piotrb5e3/AT89C2051_programmer/schematic/schematic.pdf

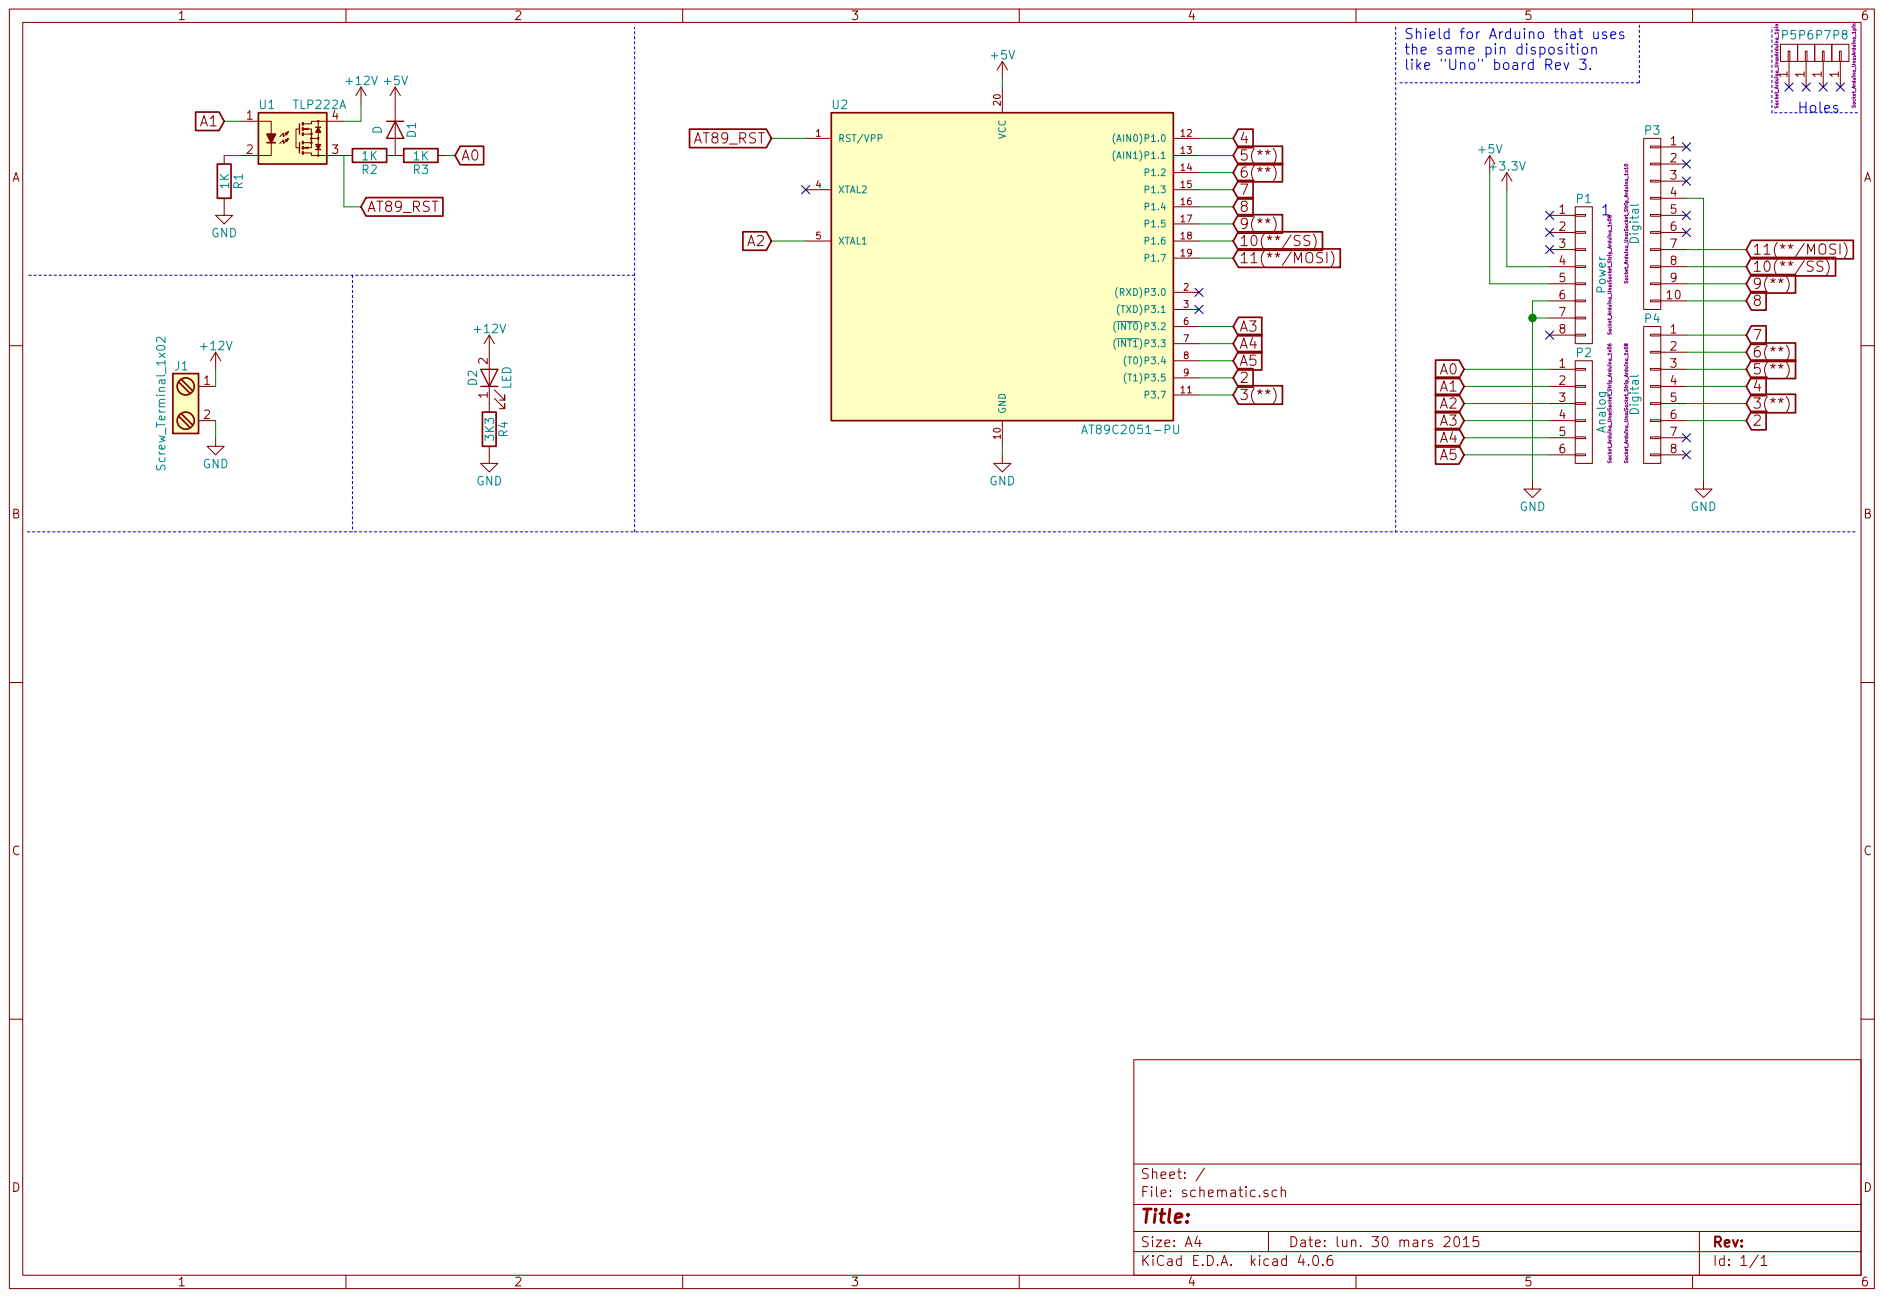
[picture p1: page 1]

Holes Shield for Arduino that uses
the same pin disposition
like "Uno" board Rev 3. 1
10 P3 Digital Socket_Arduino_Uno:Socket_Strip_Arduino_1x10 1

Id: 1/1 Title: File: schematic.sch Sheet: /
