piotrb5e3/AT89C2051_programmer/schematic/schematic.sch

## KiCad design schematic/schematic.sch (2017-05-21)

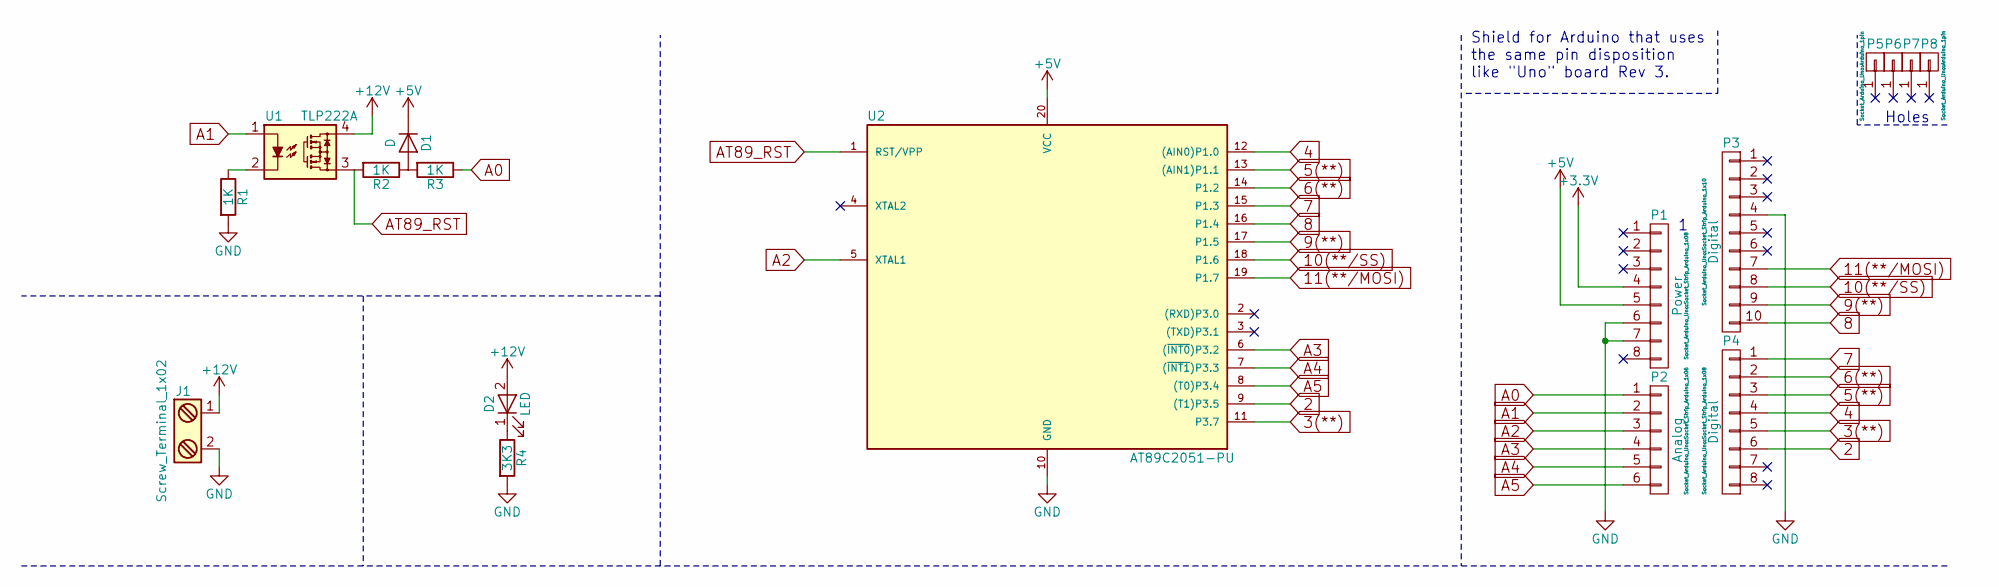
[picture p2: schematic schematic.sch]

Parts:
D1: D; D_MELF
D2: LED; LED_0805
J1: Screw_Terminal_1x02; TerminalBlock_Pheonix_MPT-2.54mm_2pol
P1: Power; Socket_Strip_Arduino_1x08
P2: Analog; Socket_Strip_Arduino_1x06
P3: Digital; Socket_Strip_Arduino_1x10
P4: Digital; Socket_Strip_Arduino_1x08
P5, P6, P7, P8: CONN_01X01; Arduino_1pin
R1, R2, R3: 1K; R_0805
R4: 3K3; R_0805
U1: TLP222A; DIP-4_W7.62mm
U2: AT89C2051-PU; DIP-20_W7.62mm

Connections:
2: P4.6, U2.9 ((T1)P3.5)
3(**): P4.5, U2.11 (P3.7)
4: P4.4, U2.12 ((AIN0)P1.0)
5(**): P4.3, U2.13 ((AIN1)P1.1)
6(**): P4.2, U2.14 (P1.2)
7: P4.1, U2.15 (P1.3)
8: P3.10, U2.16 (P1.4)
9(**): P3.9, U2.17 (P1.5)
10(**/SS): P3.8, U2.18 (P1.6)
11(**/MOSI): P3.7, U2.19 (P1.7)
+3.3V: P1.4
+5V: D1.1 (K), P1.5, U2.20 (VCC)
+12V: D2.2 (A), J1.1, U1.4
A0: P2.1, R3.1
A1: P2.2, U1.1
A2: P2.3, U2.5 (XTAL1)
A3: P2.4, U2.6 ((~INT0~)P3.2)
A4: P2.5, U2.7 ((~INT1~)P3.3)
A5: P2.6, U2.8 ((T0)P3.4)
AT89_RST: R2.2, U1.3, U2.1 (RST/VPP)
GND: J1.2, P1.6, P1.7, P3.4, R1.2, R4.2, U2.10 (GND)
unnamed: D1.2 (A), R2.1, R3.2
unnamed: D2.1 (K), R4.1
unnamed: R1.1, U1.2

Notes on the sheet:
Holes
Shield for Arduino that uses the same pin disposition like "Uno" board Rev 3.
