piotrb5e3/AT89C2051_programmer/(threads)

Thread 1 (2017-05-21):

Schematic?

dwaq, 2017-05-21:
Do you have a schematic for your programmer? I'm most interested in how you switched between the 12V/5V/0V on the RST pin. Even a sketch of this part of the circuit would help me out. Thanks in advance!

piotrb5e3, 2017-05-21:
Added kicad project with the schematic + rendered PDF. The optocoupler could also be a transistor-output one.

namebee, 2022-03-25:
Sorry for reviving such an old project, but could you explain the circuit to me? I've been trying to get into electronics and I'm really struggling to figure out how you're switching between those voltages. I'm especially struggling with the diode part.

Closed 2017-05-21.

Thread 2 (2018-06-06):

0.3.0 distribution, at89overlord fails with exception on case-sensitive file systems

tardate, 2018-06-06:
Hi @piotrb5e3, thanks for your project - it was a great help for me building something similar, but with an integrated charge pump - you can see [my project details here](https://github.com/tardate/LittleArduinoProjects/tree/master/8051/AT89C2051/Programmer) if you are interested.

I was able to keep it compatible with at89overlord, and that's the host programming software I'm using.

I ran into one issue after installing the egg under python3. It would complain about a missing `at89overlord.at89comm` module:

```
$ at89overlord
Traceback (most recent call last):
  File "....Programmer/venv/bin/at89overlord", line 7, in <module>
    from at89overlord.at89runner import main
  File "...Programmer/venv/lib/python3.5/site-packages/at89overlord/at89runner.py", line 4, in <module>
    from at89overlord.at89comm import AT89comm
ImportError: No module named 'at89overlord.at89comm'
```
There appears to be nothing wrong with the source files here, and the `at89overlord-0.3.0.tar.gz` appears ok at https://pypi.org/project/at89overlord/#files

The problem appears to be in the `at89overlord-0.3.0-py3-none-any.whl` zip that has been distributed. Specifically in `RECORD`, where I see there's been some case confusion, possible from when files were renamed and reorganised on a file system that wasn't fully case-sensitive:
```
at89overlord/AT89comm.py,sha256=AkId-9ahgtrg6ySuNmrt2Em8__jwBb9UTTYWf5knYqo,2053
at89overlord/__init__.py,sha256=47DEQpj8HBSa-_TImW-5JCeuQeRkm5NMpJWZG3hSuFU,0
at89overlord/at89comm.py,sha256=T4bd3zeMiPxSHBeJd-uPXXoi-ts8P82oAr2eLFGkRHA,4590
...
```
When I look at the files installed in site-packages, I see I have `AT89comm.py`, not `at89comm.py`, and since my file system is case-sensitive - boom!

I was able to work around this simply by patching the installed file names:
```
mv venv/lib/python3.5/site-packages/at89overlord/AT89comm.py venv/lib/python3.5/site-packages/at89overlord/at89comm.py
```

So long story short - looks like the 0.3.0 distribution is iffy, and would be worth re-packaging an update at some point.

piotrb5e3, 2018-06-07:
Thank you for the report. I'm looking into it.

piotrb5e3, 2018-06-07:
I've released the 0.4.0 version. It should fix this problem.

tardate, 2018-06-07:
confirmed! thanks, 0.4.0 installs and runs just fine.

Closed 2018-06-07.

Thread 3 (2019-01-10):

Question about optocoupler

tfry-git, 2019-01-10:
So I bought an AT89C2501-based diy clock for my kid to solder, and ... it isn't working. What a great excuse for looking into the hows of a new MCU! It looks like I'm probably going to build your programmer (and thanks for sharing!), but two questions about the optocoupler:

1) You write that an optocoupler with mosfet output is best, but I don't have that in my box. In an earlier description, you seem to have used an EL817. Will that sort of work, and what issues should I expect?

2) Why are you using an optocoupler at all? AFAIU, the problem is that you need to feed 12V, 5V, and 0V to AT89_RST. But the ground level is still the same as that of the Arduino, so why not just use a plain transistor (mosfet), to feed in the 12V? Also, why not just a plain diode between A0 and AT89_RST to protect A0 from the 12V?

tfry-git, 2019-01-10:
Ok, never mind question number 2. I see now that the ground level is *not* "the same as that of the Arduino", but either 0V or 5V, depending on A0. D'oh!

Still looking for your insight on question number 1, though.

piotrb5e3, 2019-01-17:
AD1. A transistor-output optocoupler should also work. I used what I had laying around.
AD2. The ground level is the same - see 12V terminal connections.
I used an optocoupler to make the design simpler, but a PNP BJT or a P-channel MOSFET could also work.
Schematic idea: Arduino drives an NPN that shorts the gate of the PNP to the ground to enable 12V. You can't drive a high-side PNP enabling a voltage >VCC directly from an Arduino - it will be always-on through the pin overvoltage protection diode. This version also requires careful placement of resistors to limit the base current.

tfry-git, 2019-01-22:
Thanks for your answer!

As usual, I got side-tracked, but I do plan on getting back to this. Here's my circuit idea, using two 2N7000s: http://tinyurl.com/y7dv6otj (for simplicity, I added switches connected to 12V for toggling the gates, but of course these would be connected to arduino outputs in reality.

The AT89_RST-pin is high impedance, right? Then this design should allow to get by with very few common parts. Unfortunately, it reverses the current logic, so I'd have to change the code, too. I'll keep you posted on how it goes...

steveschnepp, 2024-08-26:
I used a npn and 3 leds. https://blog.pwkf.org/2022/08/27/simple-at89c2051-programmer.html

Thread 4 (2024-10-02):

I'm getting error massage

rashhad, 2024-10-02:
Hi, I'm getting the following error messege when tring to upload hello.ihx file:
```
C:\Users\Rashad\OneDrive\Desktop\at89c2051\hello-8051>at89overlord -p COM3 -f hello.ihx
# Initializing the programmer...
# Initialized!
# Confirming chip ID...
Traceback (most recent call last):
  File "C:\Users\Rashad\AppData\Local\Programs\Python\Python310\lib\runpy.py", line 196, in _run_module_as_main
    return _run_code(code, main_globals, None,
  File "C:\Users\Rashad\AppData\Local\Programs\Python\Python310\lib\runpy.py", line 86, in _run_code
    exec(code, run_globals)
  File "C:\Users\Rashad\AppData\Local\Programs\Python\Python310\Scripts\at89overlord.exe\__main__.py", line 7, in <module>
  File "C:\Users\Rashad\AppData\Local\Programs\Python\Python310\lib\site-packages\at89overlord\at89runner.py", line 54, in main
    comm.do_confirm_signature()
  File "C:\Users\Rashad\AppData\Local\Programs\Python\Python310\lib\site-packages\at89overlord\at89comm.py", line 113, in do_confirm_signature
    raise AT89CommException(errmsg)
at89overlord.at89comm.AT89CommException: Incorrect chip signature. Expected: 1E,21 Got: FE,FE
```

I'm also using bc557 pnp trnasistor in the place of TLP222A. Please see the attached image. The complete arragement is on solderless breadboard.
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

rashhad, 2024-10-03:
Hi again! I made the setup on perfboard. I found some mistake and I added an optocoupler to my new circuit. I'm attaching the diagram. but still getting the same error message. Except the last line:
`Incorrect chip signature. Expected: 1E,21 Got: FE,FE`
becomes
`Incorrect chip signature. Expected: 1E,21 Got: FC,00`
and
`Incorrect chip signature. Expected: 1E,21 Got: 00,FC`
and
`Incorrect chip signature. Expected: 1E,21 Got: FC,FC`
alternatively.
I'm using windows 11, python 3.10.4

Updated 12v reset diagram:
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

piotrb5e3, 2024-10-03:
Hi,
In your first setup, the AT89_RST pin would never be pulled down to 0V, because the A1 pin can't go to a voltage high enough to turn off the transistor.

In your second setup, you could try measuring the voltage on AT89_RST when the optocoupler is turned on and off. I think it may also have some issues there. Maybe adding a pull-up resistor between the base and emitter of the transistor would help, but you'd have to check that yourself.

To me, the error message you are getting points to the chip not being reset/put into programming mode correctly. I used the solid-state relay component (TLP222A) specifically not to worry about transistors and voltages.

rashhad, 2024-10-03:
Thank you for the reply. On the first try, AT89C2051 IC got damaged. I did a mistake with the transistor. That might be the reason.  After making the second circuit on perfboard and replaced the IC with a new one, the code was successfully uploaded.
Thank you again for making this repo.

rashhad, 2024-10-03:
> Hi, In your first setup, the AT89_RST pin would never be pulled down to 0V, because the A1 pin can't go to a voltage high enough to turn off the transistor.
>
Yes I understood. And the worrying part was the 12V supply directly connected to arduino A1 pin which is 5V tolerant. I didn’t notice it until I failed at the first time and review the circuit. Fortunately the pin A1 was still okay.

> In your second setup, you could try measuring the voltage on AT89_RST when the optocoupler is turned on and off. I think it may also have some issues there. Maybe adding a pull-up resistor between the base and emitter of the transistor would help, but you'd have to check that yourself.
>
I did this and found it operating normally. Than I replaced the IC with new one.

piotrb5e3, 2024-10-03:
Glad to know it works for you

Closed 2024-10-03.
