piotrb5e3/AT89C2051_programmer/(commit log)

2017-05-21 Add schematic
    [schematic.sch]
2017-12-27 Features: dump device flash to file, verify flashed data, verify device signature
2018-06-07 Add meaningful long description. Fix errors reported by flake8, add testing pipeline.
    [at89comm.py, at89runner.py]
